snspzv/Senior-Design/Schematics/radarCircuit.png

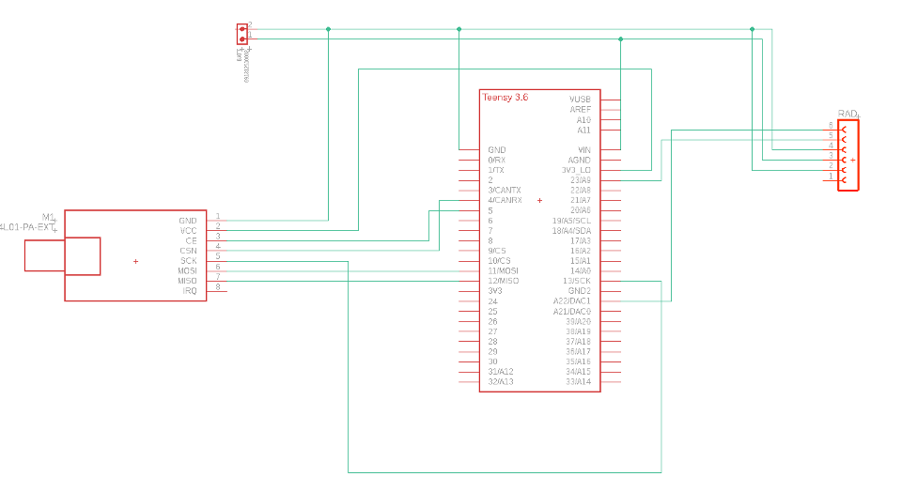
Schematics/radarCircuit.png
