snspzv/Senior-Design/Schematics/signalCircuit.png

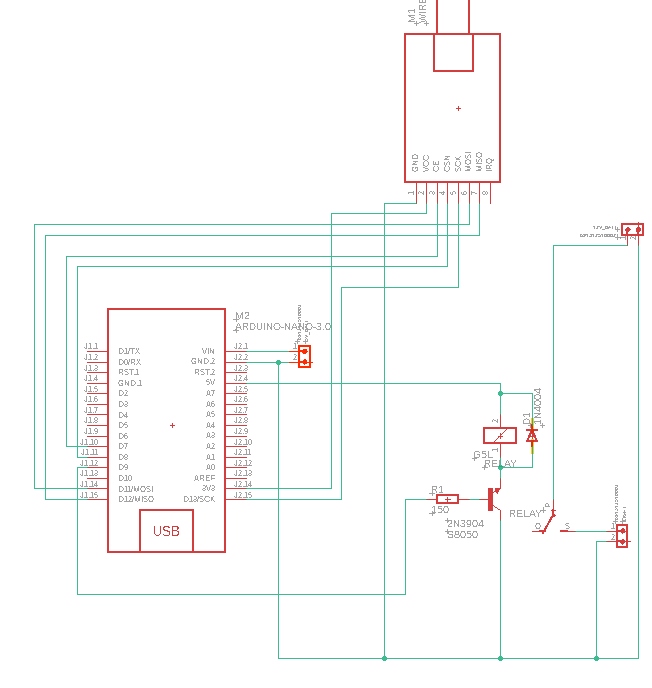
Schematics/signalCircuit.png
