snspzv/Senior-Design/(commit log)

2021-02-07 fixed error with Pin 13
2021-02-07 High power testing
2021-02-18 arduinoFFT changes
2021-02-21 adc include
2021-02-22 initial LED indicator
2021-02-22 Added comments and RELAY var
2021-02-24 light interrupts start
2021-02-24 blinker timer and regular light timer
2021-02-25 radioTimer ready for testing? light timer needs attention
2021-02-26 fixed oveerflow and moved blinking back to timer 1
    [Signal.ino, lightTimer.h, radioTimer.h]
2021-03-03 mostly working prototype
2021-03-07 Update README.md
    Added Teensy software link.
2021-03-14 adc.h to analogConversion
2021-04-26 remove radar timer file
2021-04-30 add schematics and rm tests
